izsoandras/IIT_5dof_robotarm/README.md

Foun an old 5 degree of freedom robotarm (Kalms&Mürb teach-robot) on my department. Decided to give it a new life. here is my progression.
