izsoandras/IIT_5dof_robotarm/(threads)

Thread 4 (2025-04-23):

Change reset capacitor

izsoandras, 2025-04-23:
Rst capacitor should be bigger to ensure reset on code upload via UART (probably 10uF)
