izsoandras/IIT_5dof_robotarm/PCB/IIT_5dof_arm_IO/IIT_5dof_arm_IO.kicad_sch.pdf

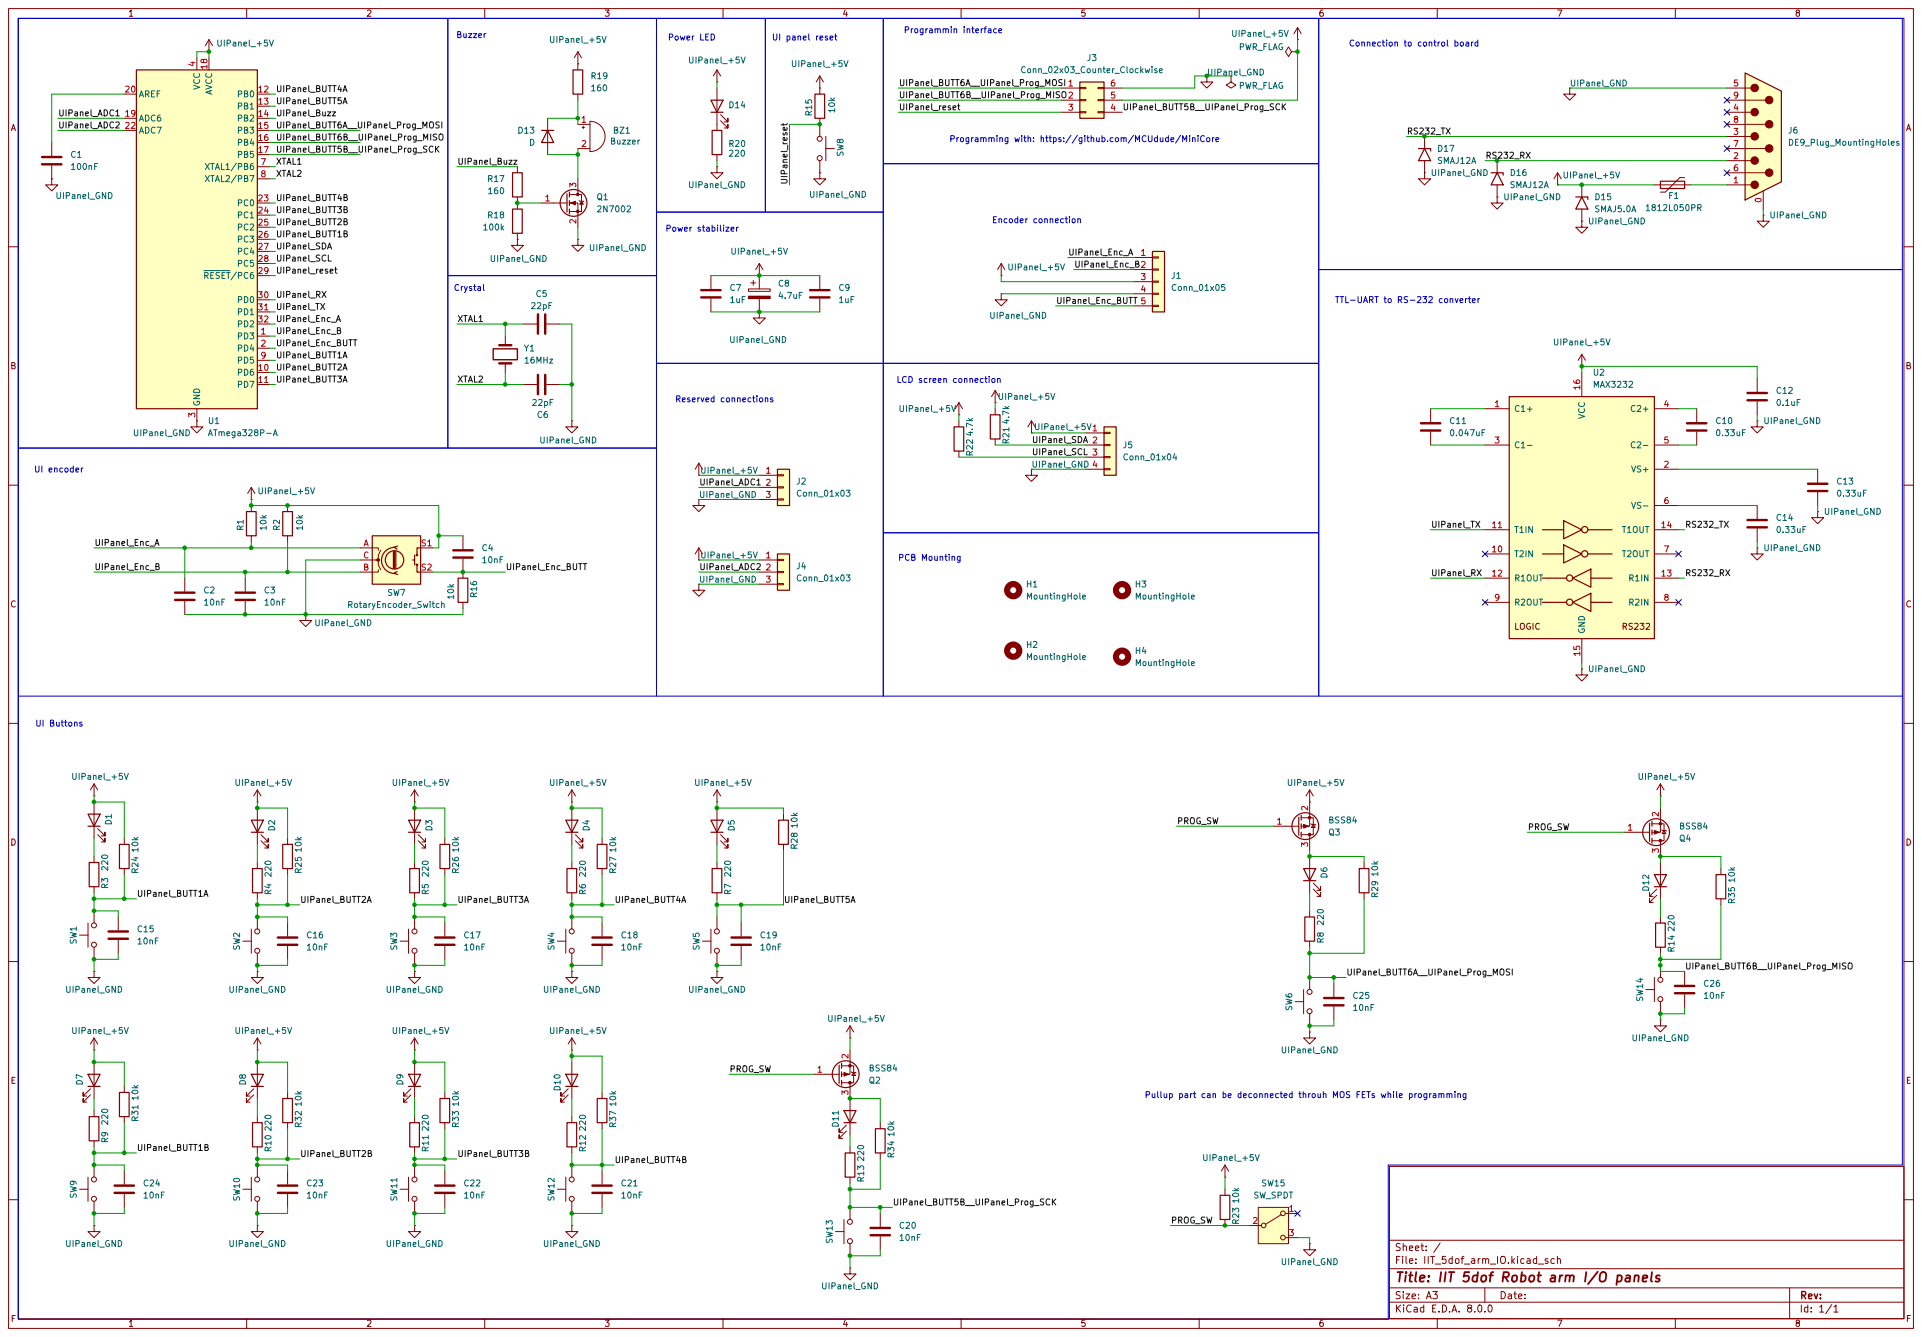
[picture p1: page 1]
