izsoandras/IIT_5dof_robotarm/PCB/IIT_5dof_arm/IIT_5dof_arm_sch.pdf

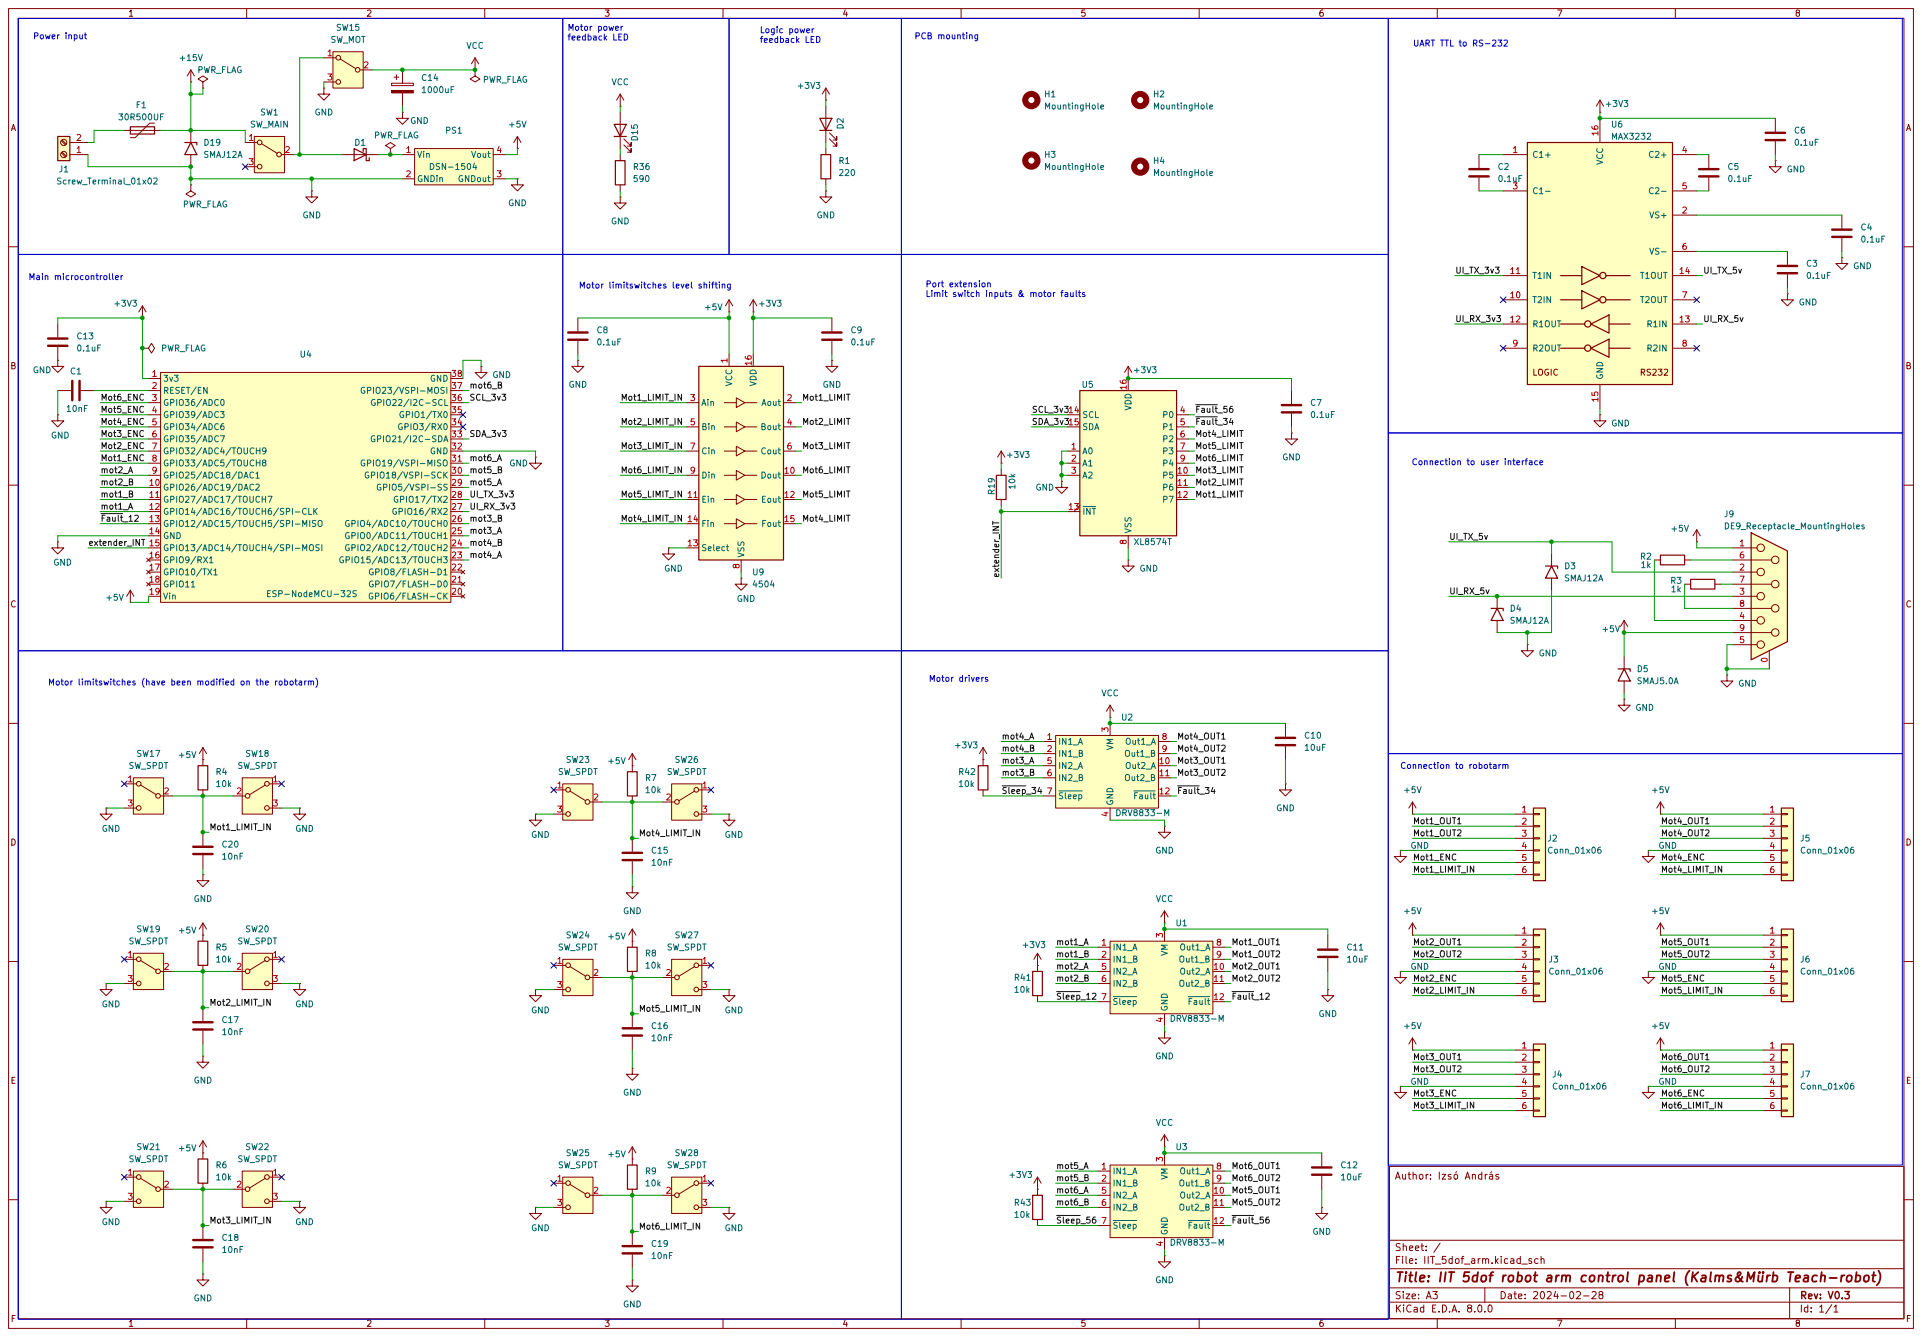
[picture p2: page 1]
