izsoandras/IIT_5dof_robotarm/PCB/IIT_5dof_arm/IIT_5dof_arm_pcb.pdf

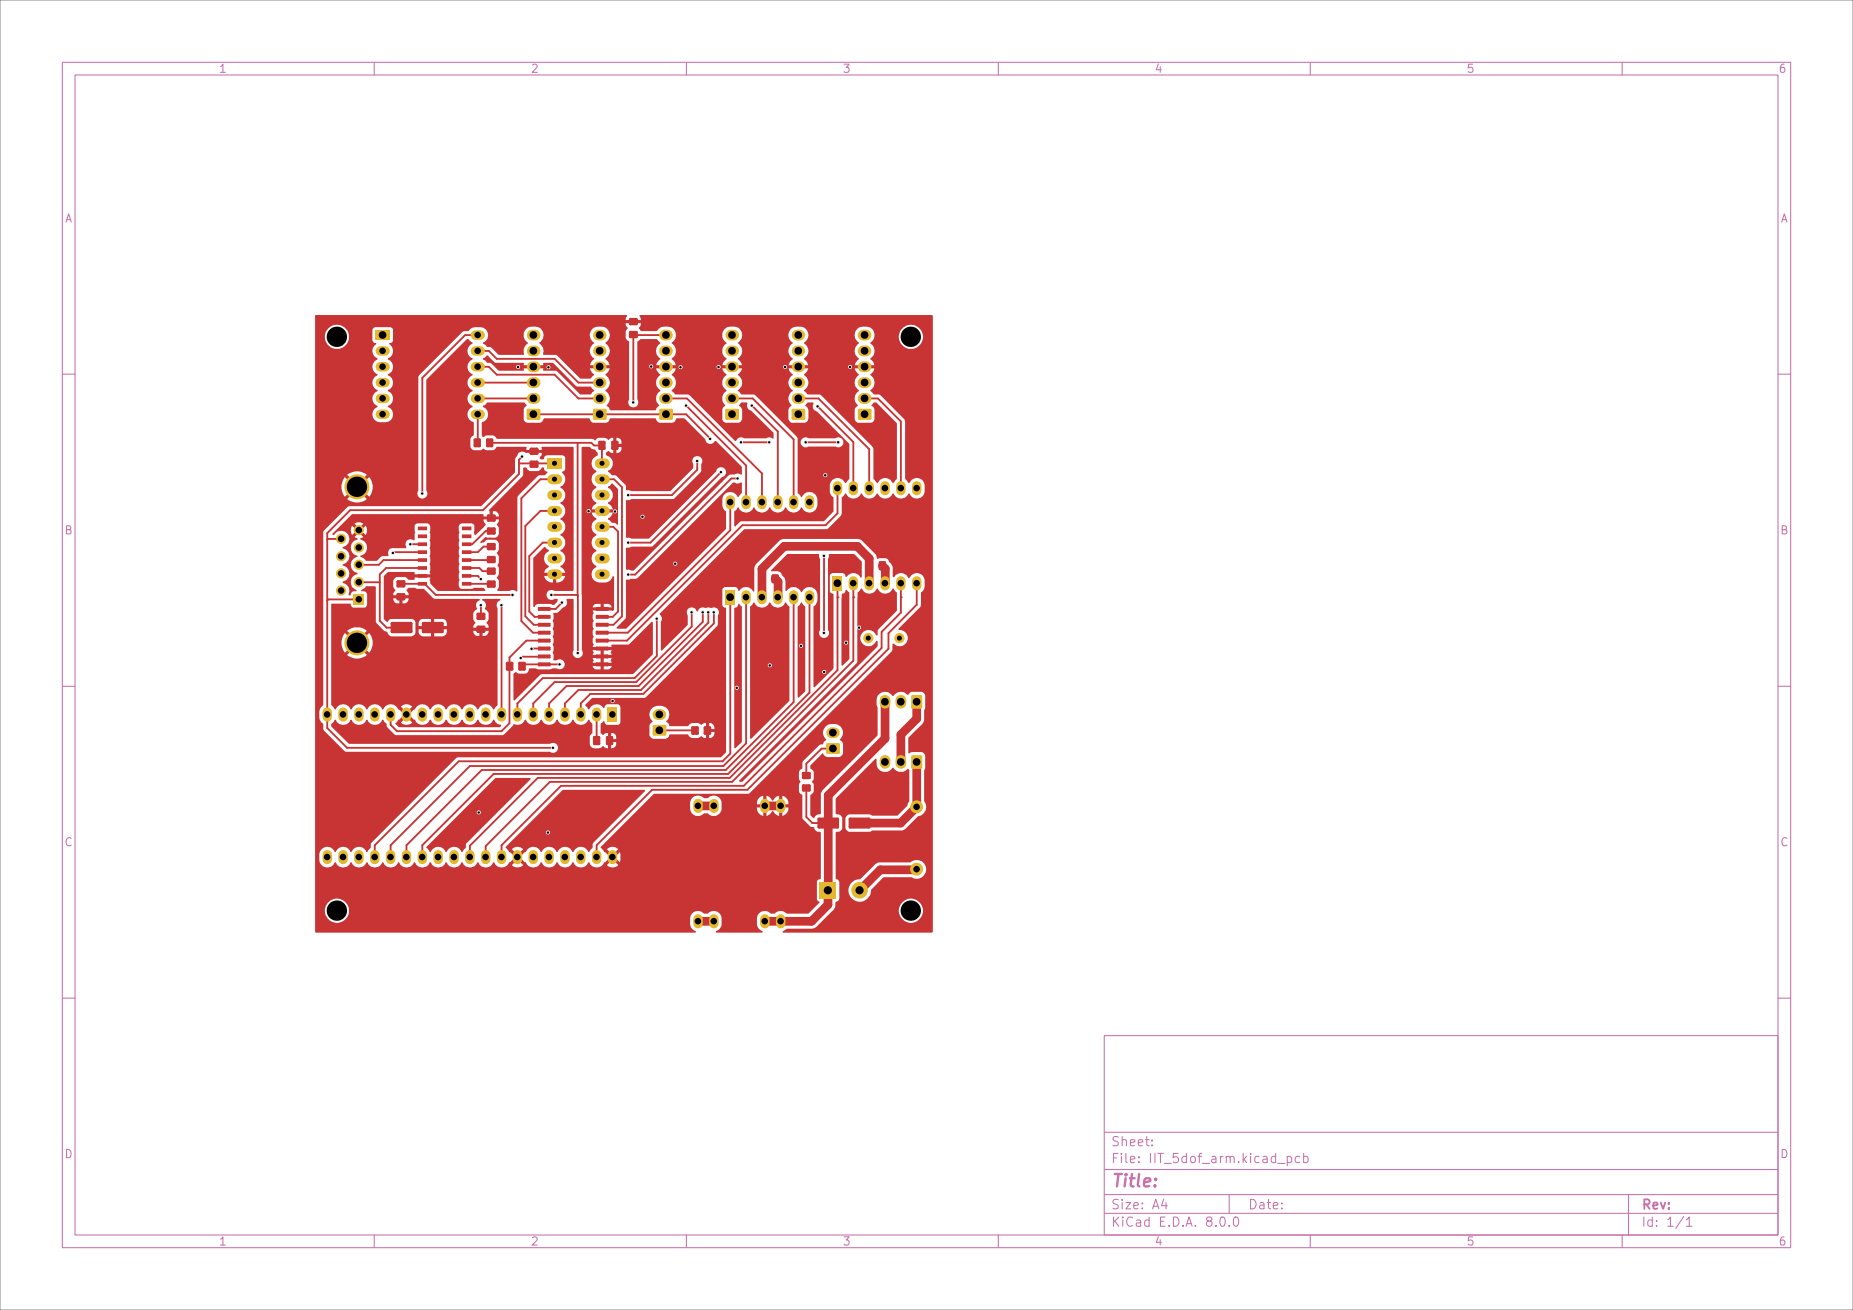
[picture p3: page 1]

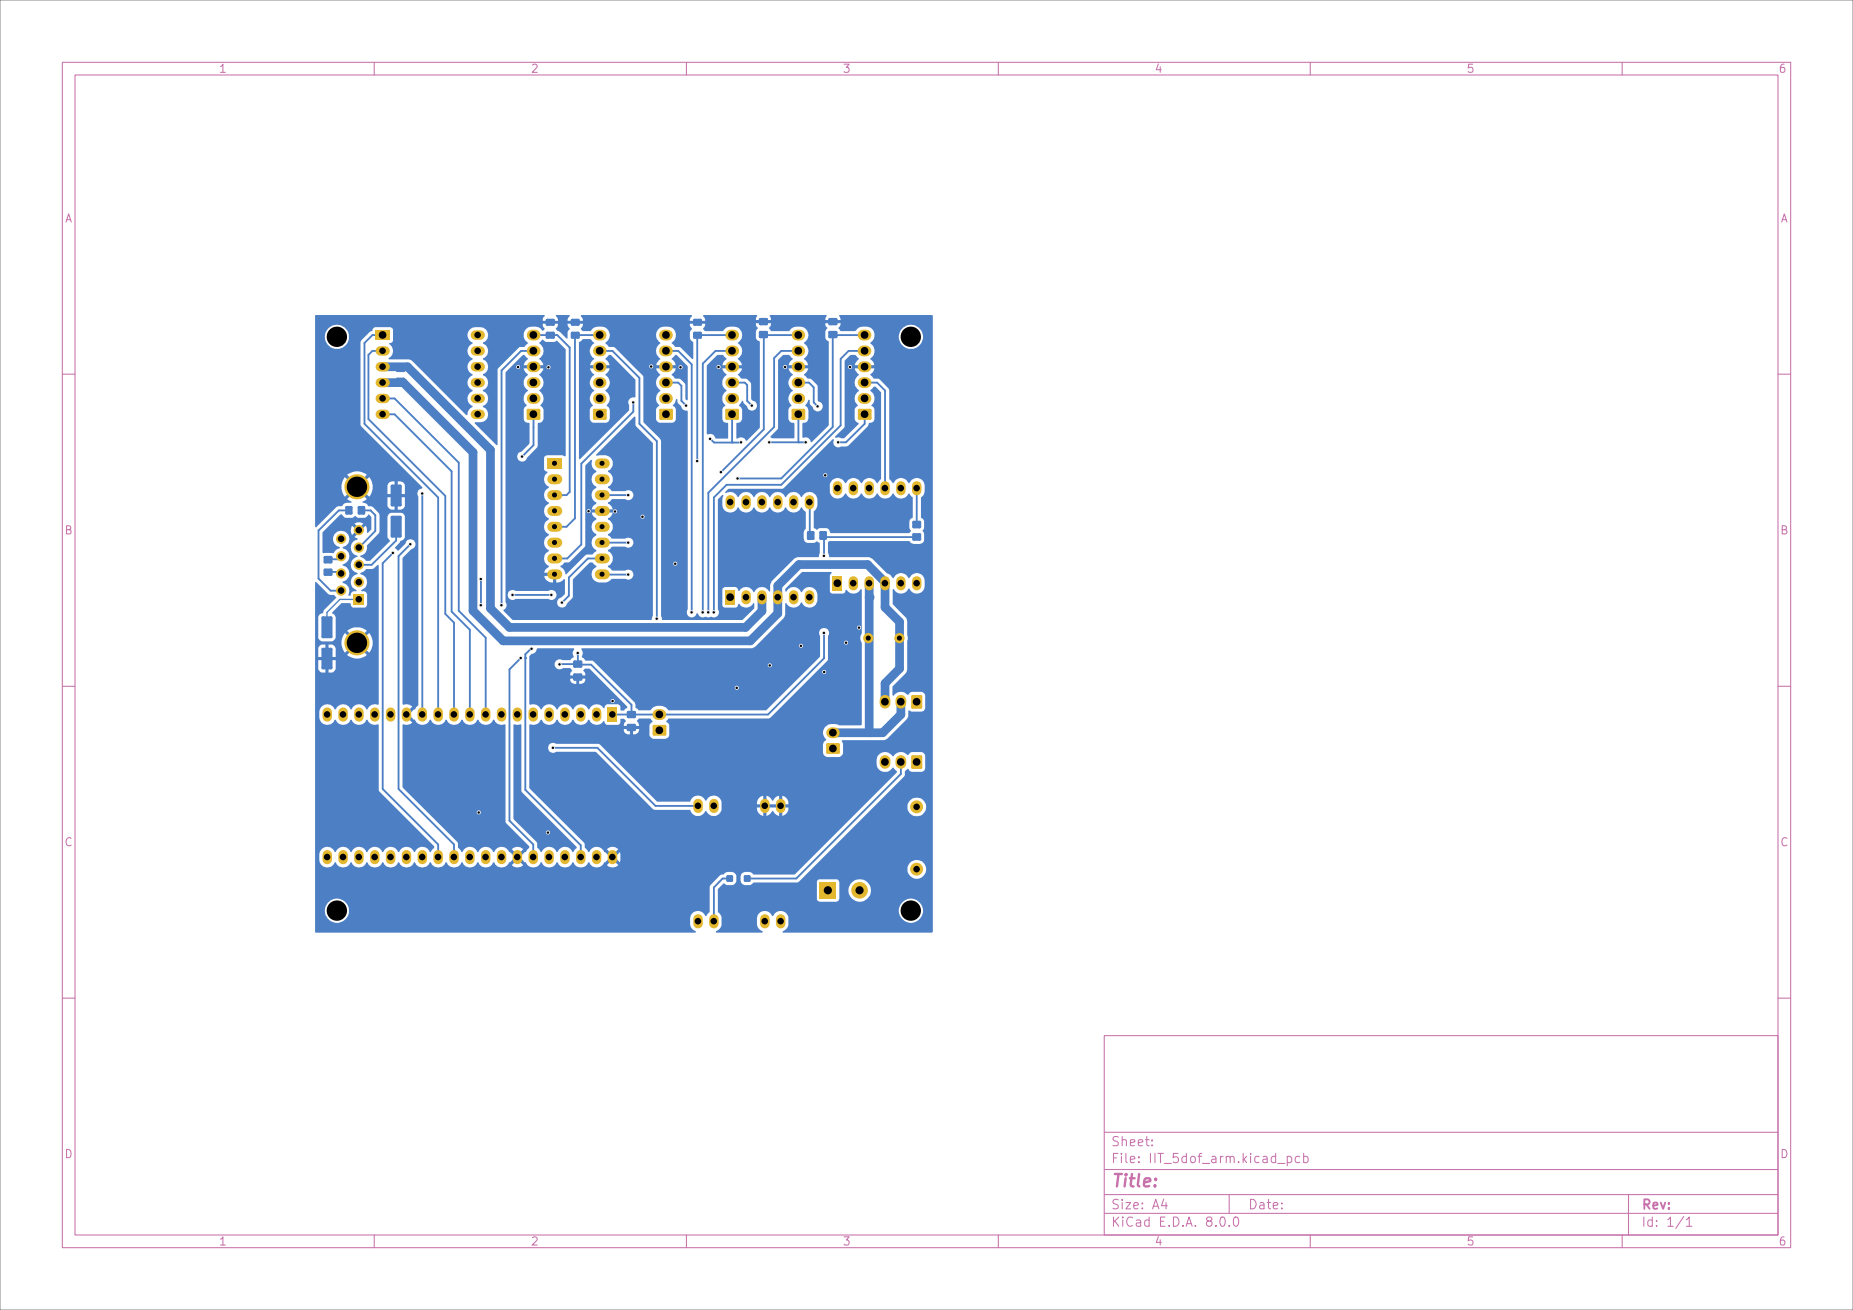
[picture p4: page 2]
