izsoandras/IIT_5dof_robotarm/PCB/IIT_5dof_arm_IO/IIT_5dof_arm_IO.kicad_pcb.pdf

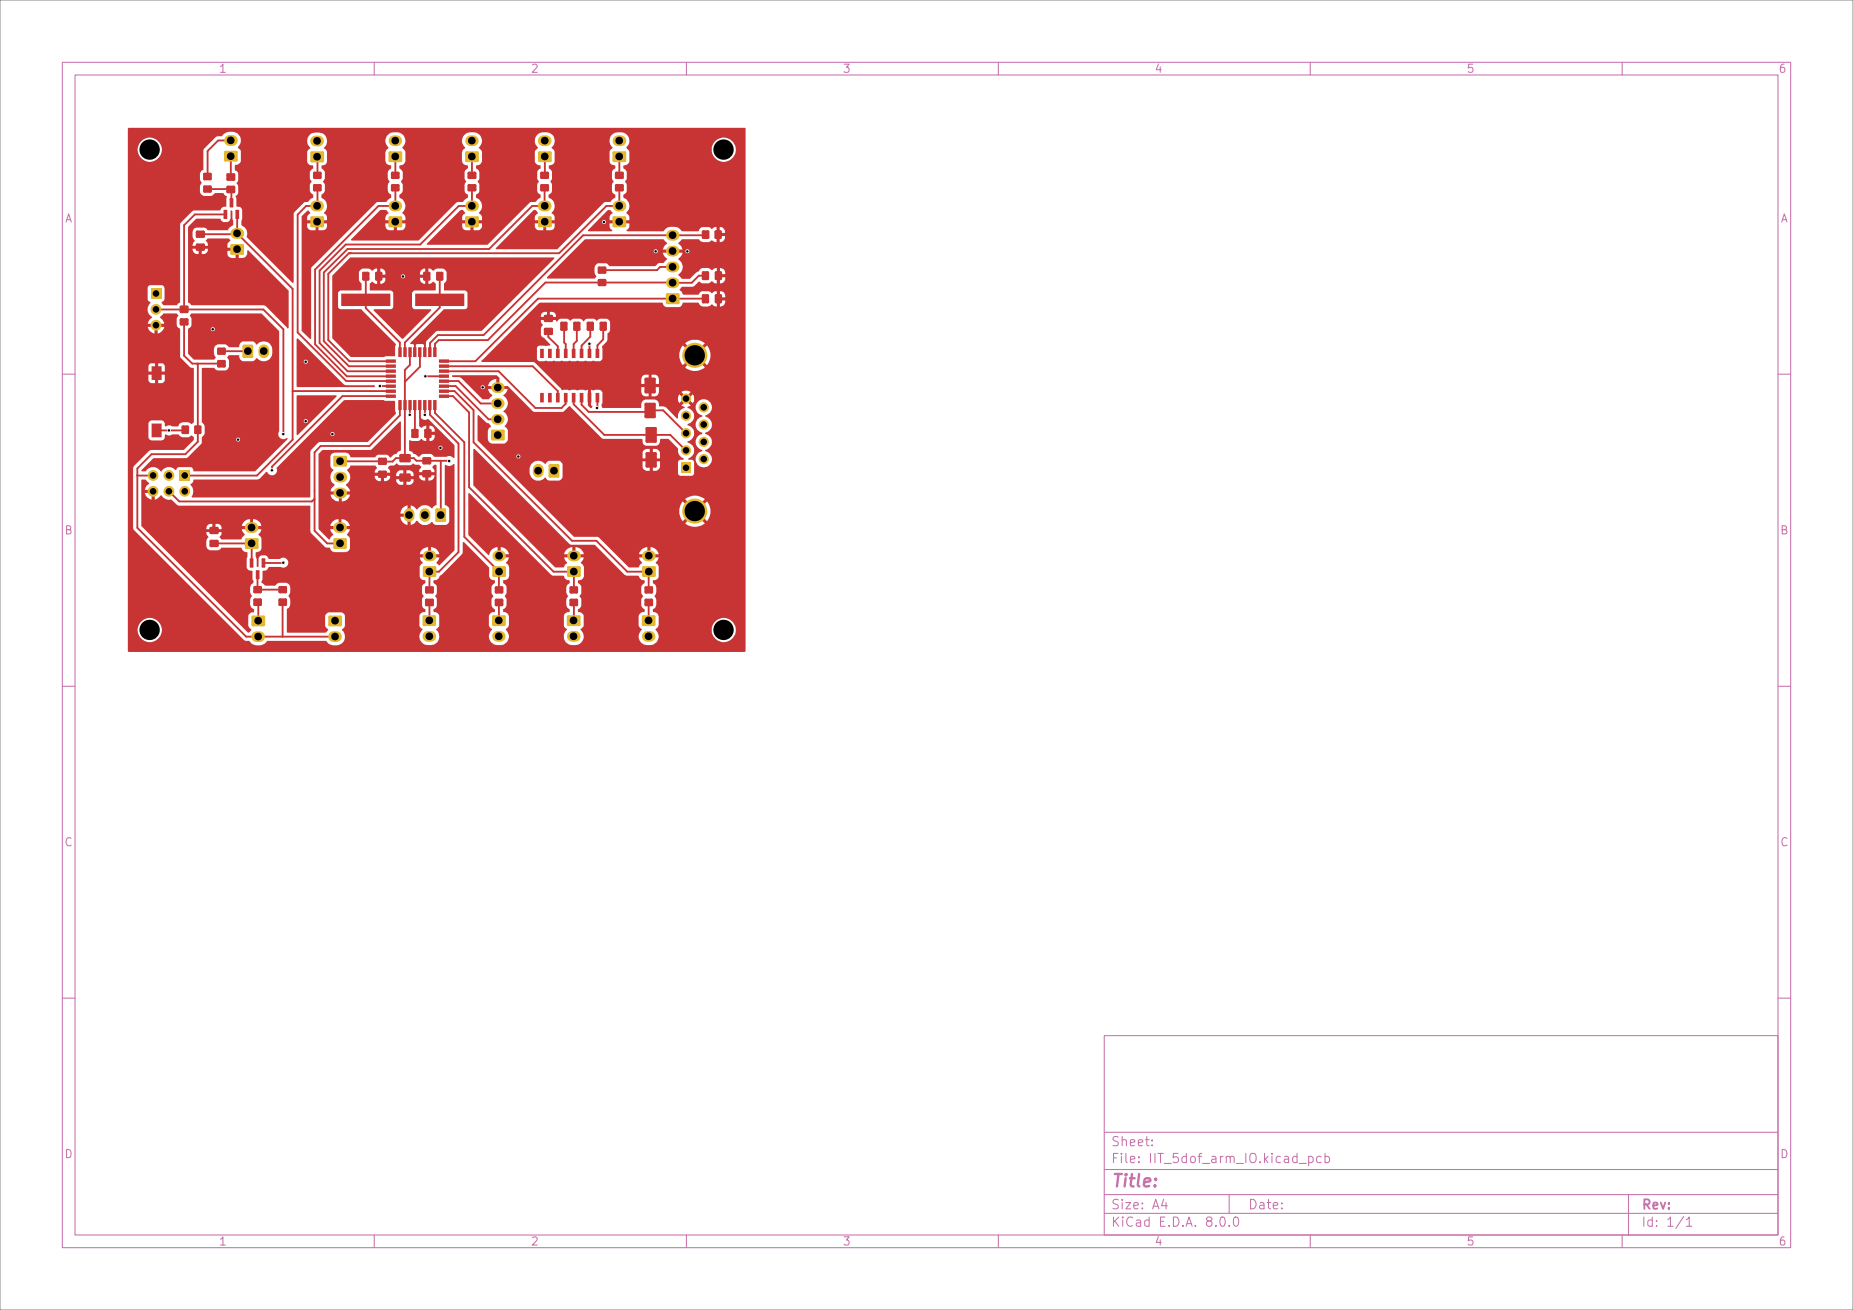
[picture p5: page 1]

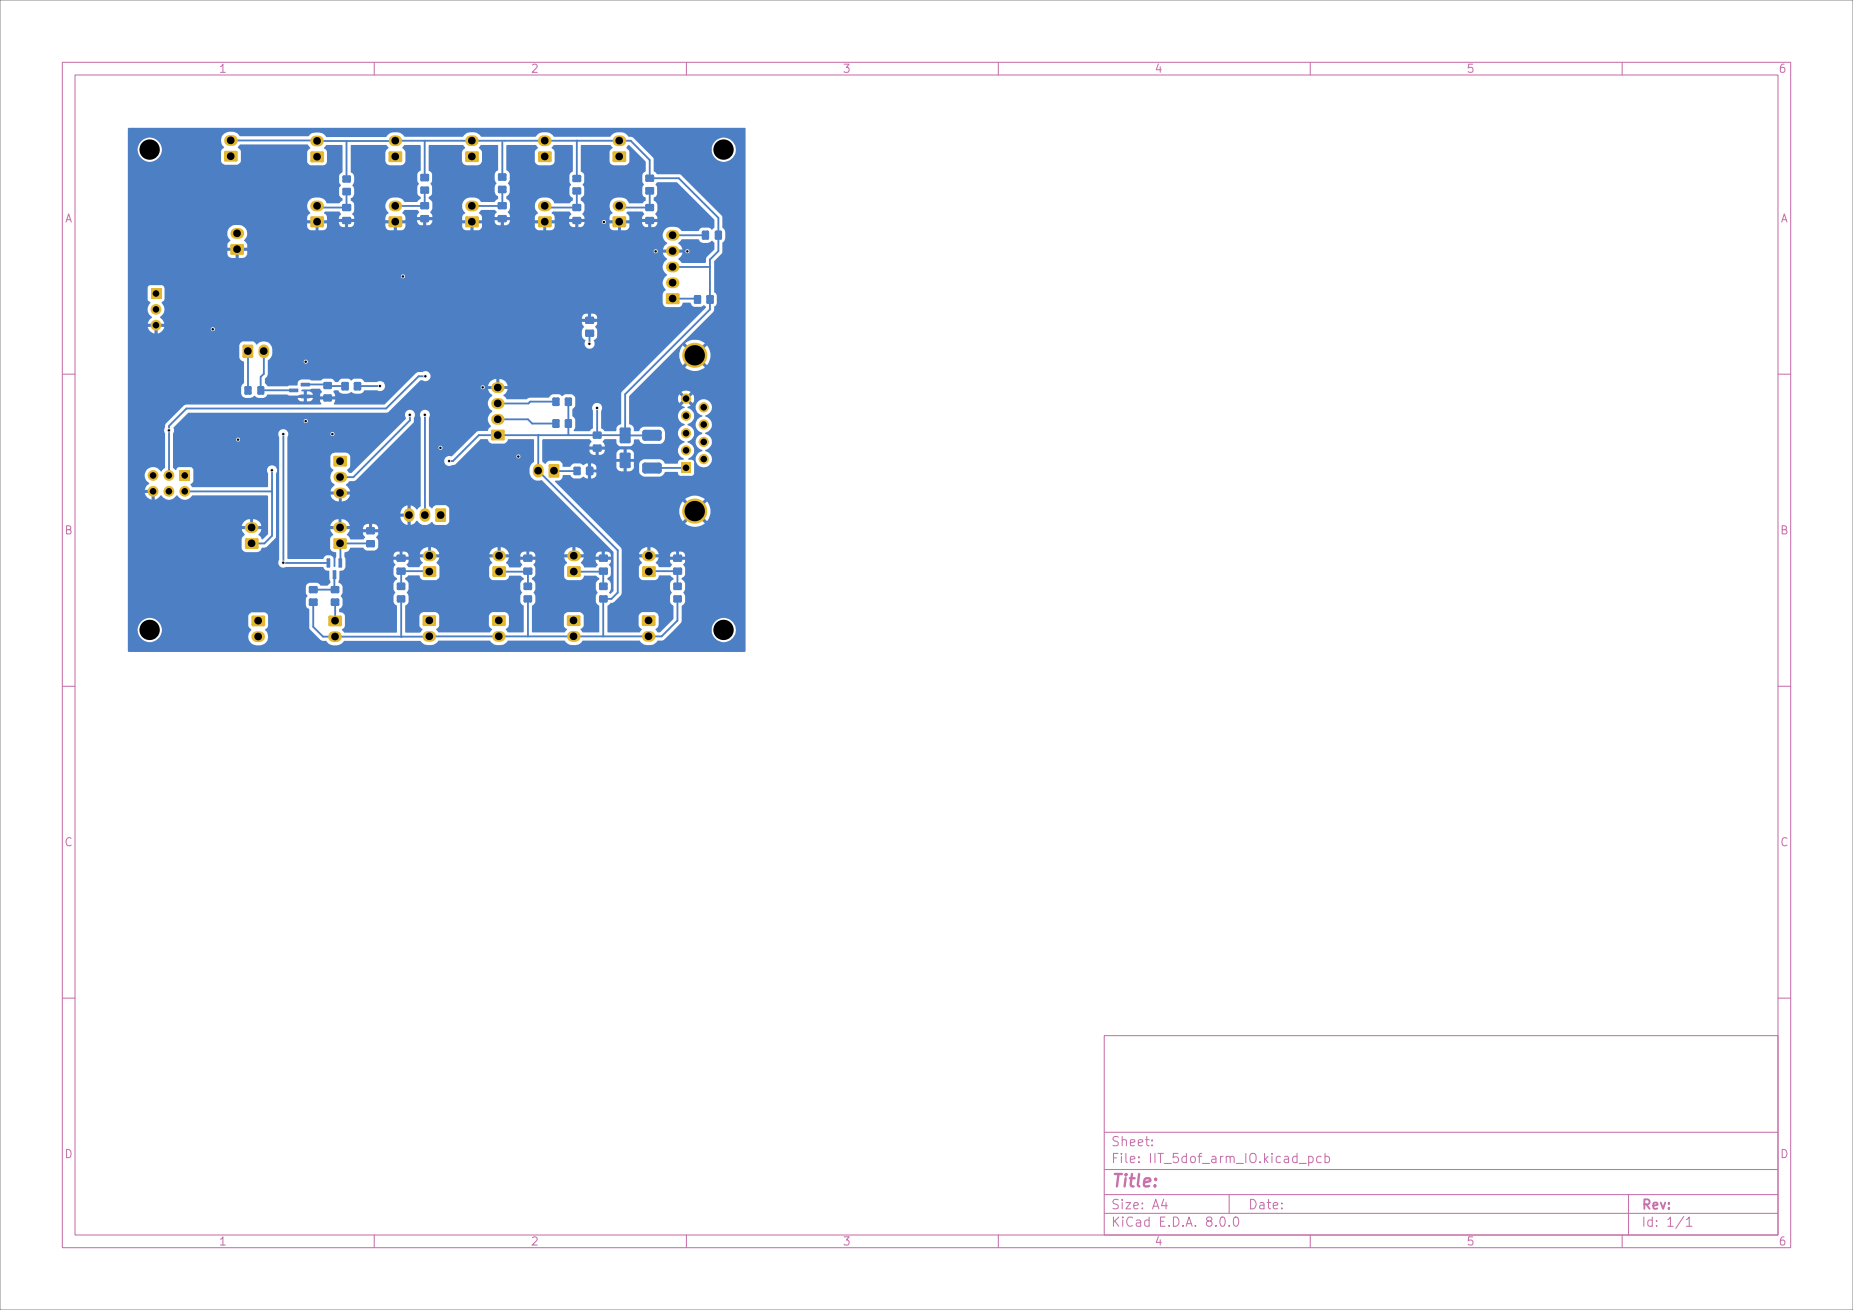
[picture p6: page 2]
