izsoandras/IIT_5dof_robotarm/PCB/IIT_5dof_arm/IIT_5dof_arm.kicad_pcb

## KiCad design PCB/IIT_5dof_arm/IIT_5dof_arm.kicad_pcb (2024-10-30)

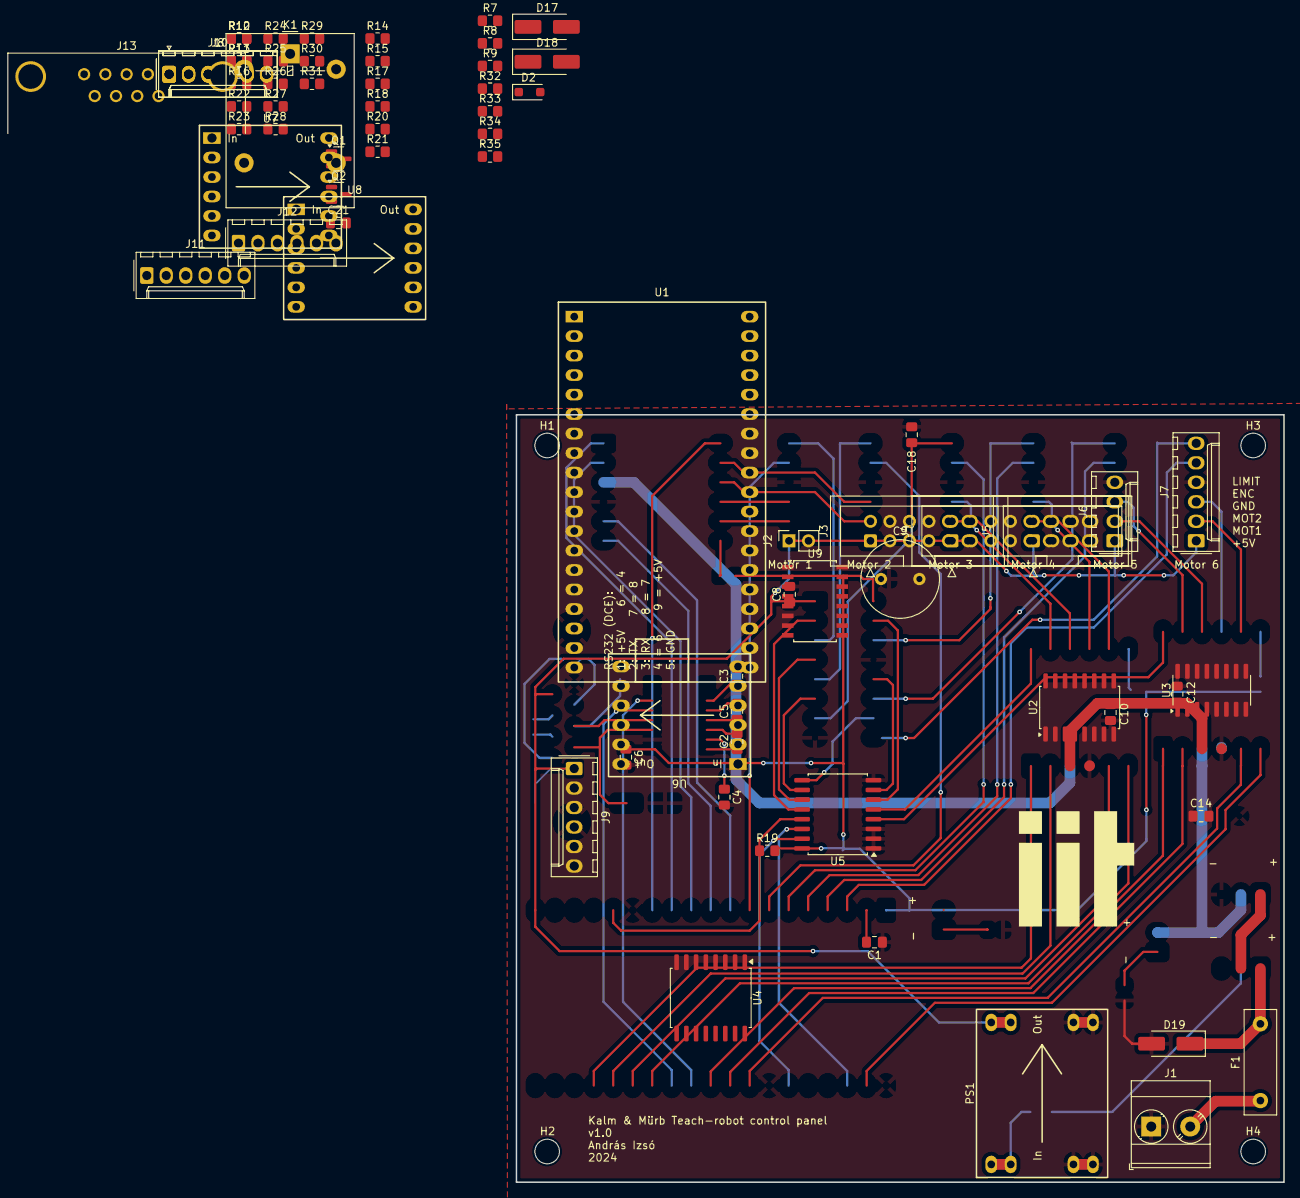
[picture p7: board IIT_5dof_arm.kicad_pcb from above]

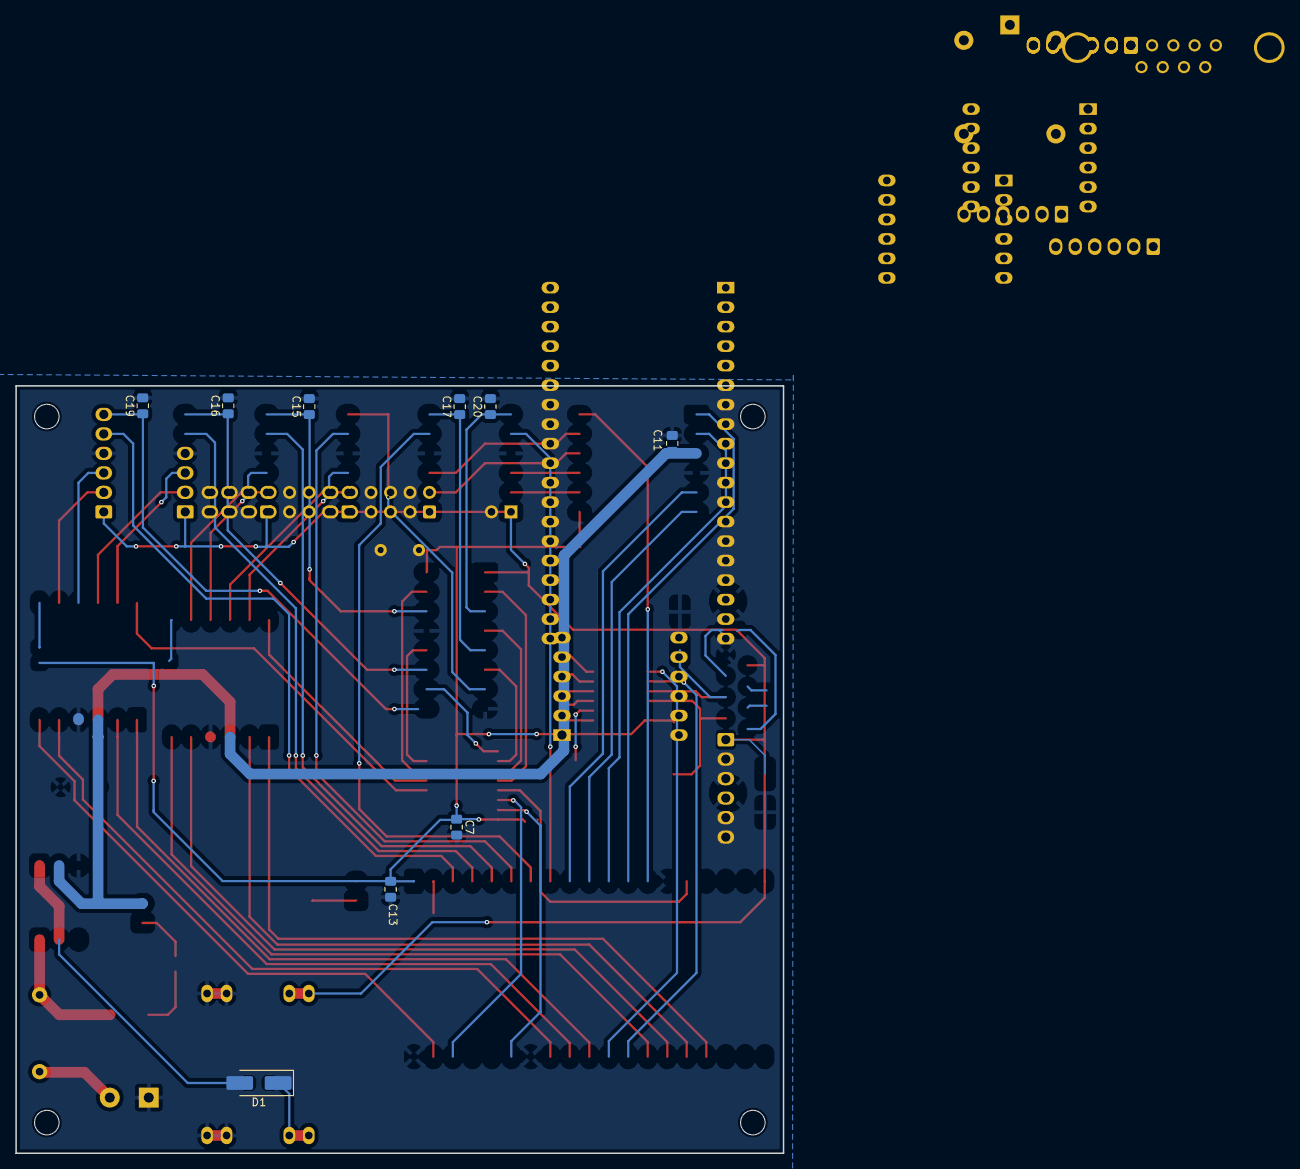
[picture p8: board IIT_5dof_arm.kicad_pcb from below]

Board: 2 copper layers, 100.0 x 100.0 mm, 86 parts (9 on the bottom side), 105 nets.

Parts:
C1, C10, C11, C13, C14, C17, C18, C19, C20, C21: 0.1uF; C_0805_2012Metric_Pad1.18x1.45mm_HandSolder
C2, C3, C4, C5, C6, C7, C8: 10nF; C_0805_2012Metric_Pad1.18x1.45mm_HandSolder
C9: 1000uF; C_Radial_D10.0mm_H16.0mm_P5.00mm
C12, C15, C16: 10uF; C_0805_2012Metric_Pad1.18x1.45mm_HandSolder
D1, D17, D18: SMAJ12A; D_SMA_Handsoldering
D2: D_Schottky; D_SOD-123F
D19: SMAJ5.0A; D_SMA_Handsoldering
F1: 30R500UF; C_Rect_L13.5mm_W4.0mm_P10.00mm_FKS3_FKP3_MKS4
H1, H2, H3, H4: MountingHole; MountingHole_3.2mm_M3
J1: Screw_Terminal_01x02; TerminalBlock_Phoenix_MKDS-3-2-5.08_1x02_P5.08mm_Horizontal
J2: Conn_01x02; PinSocket_1x02_P2.54mm_Vertical
J3: Conn_02x06_Odd_Even; IDC-Header_2x06_P2.54mm_Vertical
J4: Conn_02x08_Odd_Even; IDC-Header_2x08_P2.54mm_Vertical
J5: Conn_02x04_Odd_Even; IDC-Header_2x04_P2.54mm_Vertical
J6: Conn_01x04; Molex_KK-254_AE-6410-04A_1x04_P2.54mm_Vertical
J7, J8, J9, J10, J11, J12: Conn_01x06; Molex_KK-254_AE-6410-06A_1x06_P2.54mm_Vertical
J13: DE9_Receptacle_MountingHoles; DSUB-9_Female_Horizontal_P2.77x2.84mm_EdgePinOffset4.94mm_H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
K1: G5LE-1; Relay_SPDT_Omron-G5LE-1
PS1: DSN-1504
Q1, Q2: 2N7002; SOT-23
R7: 220; R_0805_2012Metric_Pad1.20x1.40mm_HandSolder
R8: 100k; R_0805_2012Metric_Pad1.20x1.40mm_HandSolder
R9, R13, R14, R16, R24, R25, R26, R27, R29, R31, R33: 10k; R_0805_2012Metric_Pad1.20x1.40mm_HandSolder
R10, R11, R12, R15, R17, R32, R34: 1k; R_0805_2012Metric_Pad1.20x1.40mm_HandSolder
R18, R19, R20, R21, R22, R23: 3k; R_0805_2012Metric_Pad1.20x1.40mm_HandSolder
R28, R30: 4k7; R_0805_2012Metric_Pad1.20x1.40mm_HandSolder
R35: 2k; R_0805_2012Metric_Pad1.20x1.40mm_HandSolder
U1: NodeMCU32S
U2: 74LS157; SO-16_5.3x10.2mm_P1.27mm
U3: 4504; SOIC-16_3.9x9.9mm_P1.27mm
U4, U5: XL8574T; SOIC-16W_7.5x10.3mm_P1.27mm
U6, U7, U8: DRV8833-M
U9: MAX3232; SOIC-16W_5.3x10.2mm_P1.27mm

Connections:
+3V3: C1.2, C11.1, C13.1, C14.1, C19.1, J3.1, J3.3, J3.5, J3.7, J3.9, J3.11, J4.5, J4.9, J4.13, J4.15, R24.2, R25.1, R26.1, R27.1, R28.2, R29.1, R30.2, R31.1, U1.1 (3v3), U2.16 (VCC), U3.16 (VDD), U4.16 (VDD), U5.16 (VDD), U9.16 (VCC)
+5V: C10.1, D19.1 (A1), J6.1, J7.1, J8.1, J9.1, J10.1, J11.1, J12.1, J13.1, J13.9, K1.5, PS1.4 (Vout), R33.1, U1.19 (Vin), U3.1 (VCC)
+15V: D1.1 (A1), F1.2, J5.1
/EMG_LED-: J4.10, R10.1
/EMG_signal: J5.5, Q1.1 (G), R10.2, R34.2, R35.1, U1.3 (GPIO36/ADC0)
/EMG_signal_5V: J13.7, R33.2, R34.1
/ESP-CAM/RX: J6.2, U2.6 (I1b)
/ESP-CAM/TX: J6.3, U2.9 (Zc)
/EspRST: C2.2, J2.1, U1.2 (RESET/EN)
/LED_3v3-: J4.6, R15.1
/LED_MotPower-: J4.8, R16.1
/LED_PowerOn-: J4.2, R13.1
/LED_VCC-: J4.4, R14.1
/Limit1_LED-: J3.2, R23.1
/Limit2_LED-: J3.4, R22.1
/Limit3_LED-: J3.6, R21.1
/Limit4_LED-: J3.8, R20.1
/Limit5_LED-: J3.10, R19.1
/Limit6_LED-: J3.12, R18.1
/Man/Aut SW: J5.7, R31.2, U4.5 (P1)
/Mot1_ENC: J7.5, U2.5 (I0b), U2.13 (I1d)
/Mot1_ENC/ESP-CAM_RX: U1.9 (GPIO25/ADC18/DAC1), U2.7 (Zb)
/Mot1_LIMIT: U3.2 (Aout), U5.12 (P7)
/Mot1_LIMIT_IN: C3.1, J7.6, U3.3 (Ain)
/Mot1_OUT1: J7.2, U7.8 (Out1_A)
/Mot1_OUT2: J7.3, U7.9 (Out1_B)
/Mot2_ENC: J8.5, U1.8 (GPIO33/ADC5/TOUCH8)
/Mot2_LIMIT: U3.4 (Bout), U5.11 (P6)
/Mot2_LIMIT_IN: C4.1, J8.6, U3.5 (Bin)
/Mot2_OUT1: J8.2, U7.10 (Out2_A)
/Mot2_OUT2: J8.3, U7.11 (Out2_B)
/Mot3_ENC: J9.5, U1.7 (GPIO32/ADC4/TOUCH9)
/Mot3_LIMIT: U3.6 (Cout), U5.10 (P5)
/Mot3_LIMIT_IN: C5.1, J9.6, U3.7 (Cin)
/Mot3_OUT1: J9.2, U6.10 (Out2_A)
/Mot3_OUT2: J9.3, U6.11 (Out2_B)
/Mot4_ENC: J10.5, U1.6 (GPIO35/ADC7)
/Mot4_LIMIT: U3.15 (Fout), U5.6 (P2)
/Mot4_LIMIT_IN: C6.1, J10.6, U3.14 (Fin)
/Mot4_OUT1: J10.2, U6.8 (Out1_A)
/Mot4_OUT2: J10.3, U6.9 (Out1_B)
/Mot5_ENC: J11.5, U1.5 (GPIO34/ADC6)
/Mot5_LIMIT: U3.12 (Eout), U5.7 (P3)
/Mot5_LIMIT_IN: C7.1, J11.6, U3.11 (Ein)
/Mot5_OUT1: J11.2, U8.10 (Out2_A)
/Mot5_OUT2: J11.3, U8.11 (Out2_B)
/Mot6_ENC: J12.5, U1.4 (GPIO39/ADC3)
/Mot6_LIMIT: U3.10 (Dout), U5.9 (P4)
/Mot6_LIMIT_IN: C8.1, J12.6, U3.9 (Din)
/Mot6_OUT1: J12.2, U8.8 (Out1_A)
/Mot6_OUT2: J12.3, U8.9 (Out1_B)
/MotEnable: R7.1, U4.6 (P2)
/MotPower: C12.1, C15.1, C16.1, J4.7, K1.1, U6.3 (VM), U7.3 (VM), U8.3 (VM)
/PowerOn: D2.2 (A), J4.1, J5.2, J5.3
/SCL_3v3: R28.1, U1.36 (GPIO22/I2C-SCL), U4.14 (SCL), U5.14 (SCL)
/SDA_3v3: R30.1, U1.33 (GPIO21/I2C-SDA), U4.15 (SDA), U5.15 (SDA)
/TBD_Led1: R11.2, U4.11 (P6)
/TBD_Led1-: J4.14, R11.1
/TBD_Led2: R12.2, U4.12 (P7)
/TBD_Led2-: J4.16, R12.1
/UI_RX_3v3: U1.27 (GPIO16/RX2), U9.12 (R1OUT)
/UI_RX_5v: D17.1 (A1), J13.3, U9.13 (R1IN)
/UI_TX_3v3: U1.28 (GPIO17/TX2), U9.11 (T1IN)
/UI_TX_5v: D18.1 (A1), J13.2, U9.14 (T1OUT)
/alt_mot1A: U2.3 (I1a), U4.9 (P4)
/alt_mot1_enc: U2.12 (Zd), U4.10 (P5)
/extender_INT: R24.1, U1.15 (GPIO13/ADC14/TOUCH4/SPI-MOSI), U4.13 (~INT), U5.13 (~INT)
/mot1_A: U2.4 (Za), U7.1 (IN1_A)
/mot1_A/ESP-CAM_TX: U1.13 (GPIO12/ADC15/TOUCH5/SPI-MISO), U2.2 (I0a), U2.10 (I1c)
/mot1_B: U1.12 (GPIO14/ADC16/TOUCH6/SPI-CLK), U7.2 (IN1_B)
/mot2_A: U1.10 (GPIO26/ADC19/DAC2), U7.5 (IN2_A)
/mot2_B: U1.11 (GPIO27/ADC17/TOUCH7), U7.6 (IN2_B)
/mot3_A: U1.25 (GPIO0/ADC11/TOUCH1), U6.5 (IN2_A)
/mot3_B: U1.26 (GPIO4/ADC10/TOUCH0), U6.6 (IN2_B)
/mot4_A: U1.23 (GPIO15/ADC13/TOUCH3), U6.1 (IN1_A)
/mot4_B: U1.24 (GPIO2/ADC12/TOUCH2), U6.2 (IN1_B)
/mot5_A: U1.29 (GPIO5/VSPI-SS), U8.1 (IN1_A)
/mot5_B: U1.30 (GPIO18/VSPI-SCK), U8.2 (IN1_B)
/mot6_A: U1.31 (GPIO19/VSPI-MISO), U8.5 (IN2_A)
/mot6_B: U1.37 (GPIO23/VSPI-MOSI), U8.6 (IN2_B)
/useESP-CAM: R17.1, U2.1 (S), U4.7 (P3)
/useESP-CAM_LED+: J4.11, R17.2
/~Fault_12: U4.4 (P0), U7.12 (~Fault)
/~Fault_34: U5.5 (P1), U6.12 (~Fault)
/~Fault_56: U5.4 (P0), U8.12 (~Fault)
/~Sleep_12: R26.2, U7.7 (~Sleep)
/~Sleep_34: R25.2, U6.7 (~Sleep)
/~Sleep_56: R27.2, U8.7 (~Sleep)
GND: C1.1, C2.1, C3.2, C4.2, C5.2, C6.2, C7.2, C8.2, C9.2, C10.2, C11.2, C12.2, C13.2, C14.2, C15.2, C16.2, C19.2, C20.2, C21.2, D1.2 (A2), D17.2 (A2), D18.2 (A2), D19.2 (A2), J1.1, J2.2, J4.12, J5.6, J5.8, J6.4, J7.4, J8.4, J9.4, J10.4, J11.4, J12.4, J13.0 (PAD), J13.5, PS1.2 (GNDin), PS1.3 (GNDout), Q2.2 (S), R8.2, R9.2, R13.2, R14.2, R15.2, R16.2, R18.2, R19.2, R20.2, R21.2, R22.2, R23.2, R35.2, U1.14 (GND), U1.32 (GND), U1.38 (GND), U2.8 (GND), U3.8 (VSS), U3.13 (Select), U4.2 (A1), U4.3 (A2), U4.8 (VSS), U5.1 (A0), U5.2 (A1), U5.3 (A2), U5.8 (VSS), U6.4 (GND), U7.4 (GND), U8.4 (GND), U9.15 (GND)
unnamed: D2.1 (K), PS1.1 (Vin)
unnamed: F1.1, J1.2
unnamed: J13.4, R32.1
unnamed: J13.6, R32.2
unnamed: K1.2, Q1.3 (D)
unnamed: Q1.2 (S), Q2.3 (D)
unnamed: Q2.1 (G), R7.2, R8.1
unnamed: R9.1, U2.11 (I0c), U2.14 (I0d), U2.15 (E)
unnamed: R29.2, U4.1 (A0)
unnamed: C17.1, U9.1 (C1+)
unnamed: C17.2, U9.3 (C1-)
unnamed: C18.1, U9.4 (C2+)
unnamed: C18.2, U9.5 (C2-)
unnamed: C21.1, U9.2 (VS+)
unnamed: C20.1, U9.6 (VS-)
VCC: C9.1, J4.3, J5.4, K1.3
