izsoandras/IIT_5dof_robotarm/PCB/IIT_5dof_arm_IO/IIT_5dof_arm_IO.kicad_pcb

## KiCad design PCB/IIT_5dof_arm_IO/IIT_5dof_arm_IO.kicad_pcb (2024-09-21)

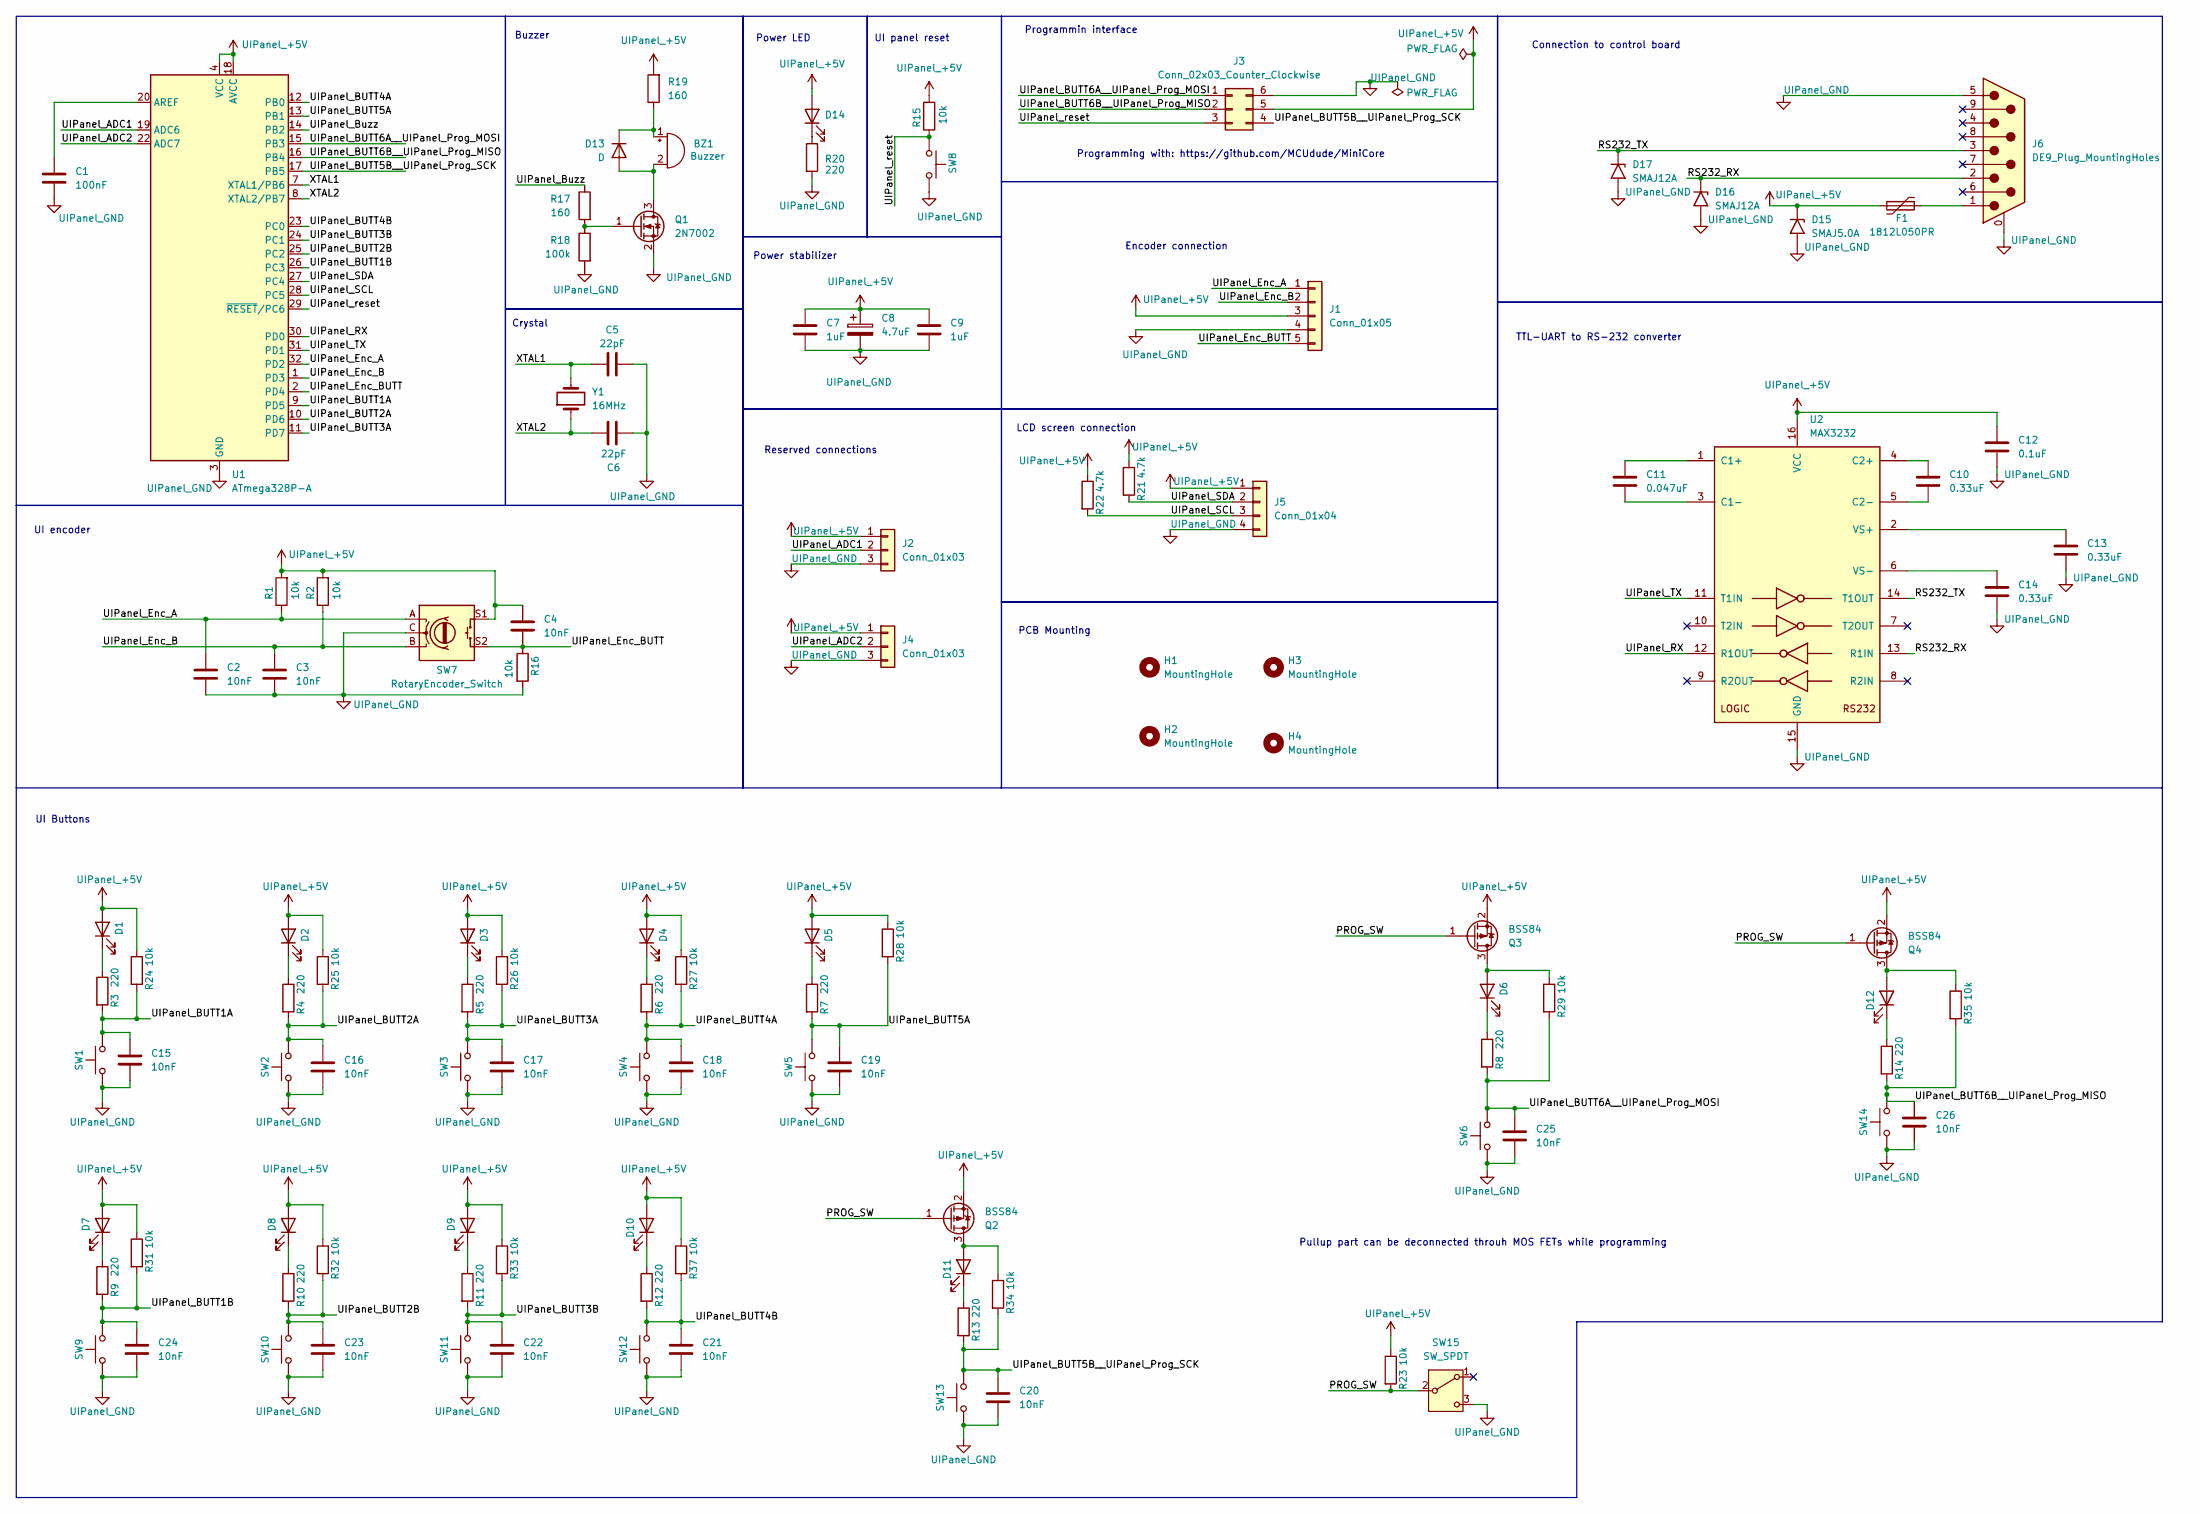
[picture p9: schematic IIT_5dof_arm_IO.kicad_sch, IIT 5dof Robot arm I/O panels]

Parts:
BZ1: Buzzer; Molex_KK-254_AE-6410-02A_1x02_P2.54mm_Vertical
C1: 100nF; C_0805_2012Metric_Pad1.18x1.45mm_HandSolder
C2, C3, C4, C15, C16, C17, C18, C19, C20, C21, C22, C23, C24, C25, C26: 10nF; C_0805_2012Metric_Pad1.18x1.45mm_HandSolder
C5, C6: 22pF; C_0805_2012Metric_Pad1.18x1.45mm_HandSolder
C7, C9: 1uF; C_0805_2012Metric_Pad1.18x1.45mm_HandSolder
C8: 4.7uF; C_1206_3216Metric_Pad1.33x1.80mm_HandSolder
C10, C13, C14: 0.33uF; C_0805_2012Metric_Pad1.18x1.45mm_HandSolder
C11: 0.047uF; C_0805_2012Metric_Pad1.18x1.45mm_HandSolder
C12: 0.1uF; C_0805_2012Metric_Pad1.18x1.45mm_HandSolder
D1, D2, D3, D4, D5, D6, D7, D8, D9, D10, D11, D12, D14: LED; Molex_KK-254_AE-6410-02A_1x02_P2.54mm_Vertical
D13: D; D_0805_2012Metric_Pad1.15x1.40mm_HandSolder
D15: SMAJ5.0A; D_SMA
D16, D17: SMAJ12A; D_SMA
F1: 1812L050PR; 1812L050PR__1.78mm_3.15mm_3.45mm
H1, H2, H3, H4: MountingHole; MountingHole_3.2mm_M3
J1: Conn_01x05; Molex_KK-254_AE-6410-05A_1x05_P2.54mm_Vertical
J2, J4: Conn_01x03; Molex_KK-254_AE-6410-03A_1x03_P2.54mm_Vertical
J3: Conn_02x03_Counter_Clockwise; PinHeader_2x03_P2.54mm_Vertical
J5: Conn_01x04; Molex_KK-254_AE-6410-04A_1x04_P2.54mm_Vertical
J6: DE9_Plug_MountingHoles; DSUB-9_Male_Horizontal_P2.77x2.84mm_EdgePinOffset7.70mm_Hou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
Q1: 2N7002; SOT-23
Q2, Q3, Q4: BSS84; SOT-23
R1, R2, R15, R16, R23, R24, R25, R26, R27, R28, R29, R31, R32, R33, R34, R35, R37: 10k; R_0805_2012Metric_Pad1.20x1.40mm_HandSolder
R3, R4, R5, R6, R7, R8, R9, R10, R11, R12, R13, R14, R20: 220; R_0805_2012Metric_Pad1.20x1.40mm_HandSolder
R17, R19: 160; R_0805_2012Metric_Pad1.20x1.40mm_HandSolder
R18: 100k; R_0805_2012Metric_Pad1.20x1.40mm_HandSolder
R21, R22: 4.7k; R_0805_2012Metric_Pad1.20x1.40mm_HandSolder
SW1, SW2, SW3, SW4, SW5, SW6, SW9, SW10, SW11, SW12, SW13, SW14: SW_Push; Molex_KK-254_AE-6410-02A_1x02_P2.54mm_Vertical
SW7: RotaryEncoder_Switch; Molex_for_encoder_1x05_P2.54mm_Vertical
SW8: SW_Push; SW_SPST_FSMSM
SW15: SW_SPDT; PinHeader_1x03_P2.54mm_Vertical
U1: ATmega328P-A; TQFP-32_7x7mm_P0.8mm
U2: MAX3232; SOIC-16W_5.3x10.2mm_P1.27mm
Y1: 16MHz; Crystal_SMD_HC49-SD_HandSoldering

Connections:
/PROG_SW: Q2.1 (G), Q3.1 (G), Q4.1 (G), R23.2, SW15.2 (B)
/RS232_RX: D16.1 (A1), J6.2, U2.13 (R1IN)
/RS232_TX: D17.1 (A1), J6.3, U2.14 (T1OUT)
/UIPanel_ADC1: J2.2, U1.19 (ADC6)
/UIPanel_ADC2: J4.2, U1.22 (ADC7)
/UIPanel_BUTT1A: C15.1, R3.2, R24.2, SW1.2, U1.9 (PD5)
/UIPanel_BUTT1B: C24.1, R9.2, R31.2, SW9.1, U1.26 (PC3)
/UIPanel_BUTT2A: C16.1, R4.2, R25.2, SW2.2, U1.10 (PD6)
/UIPanel_BUTT2B: C23.1, R10.2, R32.2, SW10.1, U1.25 (PC2)
/UIPanel_BUTT3A: C17.1, R5.2, R26.2, SW3.2, U1.11 (PD7)
/UIPanel_BUTT3B: C22.1, R11.2, R33.2, SW11.1, U1.24 (PC1)
/UIPanel_BUTT4A: C18.1, R6.2, R27.2, SW4.2, U1.12 (PB0)
/UIPanel_BUTT4B: C21.1, R12.2, R37.2, SW12.1, U1.23 (PC0)
/UIPanel_BUTT5A: C19.1, R7.2, R28.2, SW5.2, U1.13 (PB1)
/UIPanel_BUTT5B__UIPanel_Prog_SCK: C20.1, J3.4, R13.2, R34.2, SW13.1, U1.17 (PB5)
/UIPanel_BUTT6A__UIPanel_Prog_MOSI: C25.1, J3.1, R8.2, R29.2, SW6.2, U1.15 (PB3)
/UIPanel_BUTT6B__UIPanel_Prog_MISO: C26.1, J3.2, R14.2, R35.2, SW14.1, U1.16 (PB4)
/UIPanel_Buzz: R17.1, U1.14 (PB2)
/UIPanel_Enc_A: C2.1, J1.1, R1.1, SW7.A, U1.32 (PD2)
/UIPanel_Enc_B: C3.1, J1.2, R2.1, SW7.B, U1.1 (PD3)
/UIPanel_Enc_BUTT: C4.2, J1.5, R16.1, SW7.S2, U1.2 (PD4)
/UIPanel_RX: U1.30 (PD0), U2.12 (R1OUT)
/UIPanel_SCL: J5.3, R22.2, U1.28 (PC5)
/UIPanel_SDA: J5.2, R21.2, U1.27 (PC4)
/UIPanel_TX: U1.31 (PD1), U2.11 (T1IN)
/UIPanel_reset: J3.3, R15.1, SW8.1, U1.29 (~RESET/PC6)
/XTAL1: C5.1, U1.7 (XTAL1/PB6), Y1.2
/XTAL2: C6.2, U1.8 (XTAL2/PB7), Y1.1
unnamed: BZ1.1 (+), D13.1 (K), R19.1
unnamed: BZ1.2 (-), D13.2 (A), Q1.3 (D)
unnamed: D1.1 (K), R3.1
unnamed: D2.1 (K), R4.1
unnamed: D3.1 (K), R5.1
unnamed: D4.1 (K), R6.1
unnamed: D5.1 (K), R7.1
unnamed: D6.2 (A), Q3.3 (D), R29.1
unnamed: D6.1 (K), R8.1
unnamed: D7.1 (K), R9.1
unnamed: D8.1 (K), R10.1
unnamed: D9.1 (K), R11.1
unnamed: D10.1 (K), R12.1
unnamed: D11.2 (A), Q2.3 (D), R34.1
unnamed: D11.1 (K), R13.1
unnamed: D12.2 (A), Q4.3 (D), R35.1
unnamed: D12.1 (K), R14.1
unnamed: D14.1 (K), R20.1
unnamed: F1.1, J6.1
unnamed: Q1.1 (G), R17.2, R18.1
unnamed: C1.1, U1.20 (AREF)
unnamed: C11.1, U2.1 (C1+)
unnamed: C11.2, U2.3 (C1-)
unnamed: C10.1, U2.4 (C2+)
unnamed: C10.2, U2.5 (C2-)
unnamed: C13.1, U2.2 (VS+)
unnamed: C14.1, U2.6 (VS-)
UIPanel_+5V: C4.1, C7.1, C8.1, C9.1, C12.1, D1.2 (A), D2.2 (A), D3.2 (A), D4.2 (A), D5.2 (A), D7.2 (A), D8.2 (A), D9.2 (A), D10.2 (A), D14.2 (A), D15.1 (A1), F1.2, J1.3, J2.1, J3.5, J4.1, J5.1, Q2.2 (S), Q3.2 (S), Q4.2 (S), R1.2, R2.2, R15.2, R19.2, R21.1, R22.1, R23.1, R24.1, R25.1, R26.1, R27.1, R28.1, R31.1, R32.1, R33.1, R37.1, SW7.S1, U1.4 (VCC), U1.6 (VCC), U1.18 (AVCC), U2.16 (VCC)
UIPanel_GND: C1.2, C2.2, C3.2, C5.2, C6.1, C7.2, C8.2, C9.2, C12.2, C13.2, C14.2, C15.2, C16.2, C17.2, C18.2, C19.2, C20.2, C21.2, C22.2, C23.2, C24.2, C25.2, C26.2, D15.2 (A2), D16.2 (A2), D17.2 (A2), J1.4, J2.3, J3.6, J4.3, J5.4, J6.0 (PAD), J6.5, Q1.2 (S), R16.2, R18.2, R20.2, SW1.1, SW2.1, SW3.1, SW4.1, SW5.1, SW6.1, SW7.C, SW8.2, SW9.2, SW10.2, SW11.2, SW12.2, SW13.2, SW14.2, SW15.3 (C), U1.3 (GND), U1.5 (GND), U1.21 (GND), U2.15 (GND)

Notes on the sheet:
Crystal
Power LED
Connection to control board
Reserved connections
Programming with: https://github.com/MCUdude/MiniCore
Programmin interface
UI encoder
UI panel reset
PCB Mounting
Buzzer
UI Buttons
Encoder connection
LCD screen connection
Power stabilizer
Pullup part can be deconnected throuh MOS FETs while programming
TTL-UART to RS-232 converter

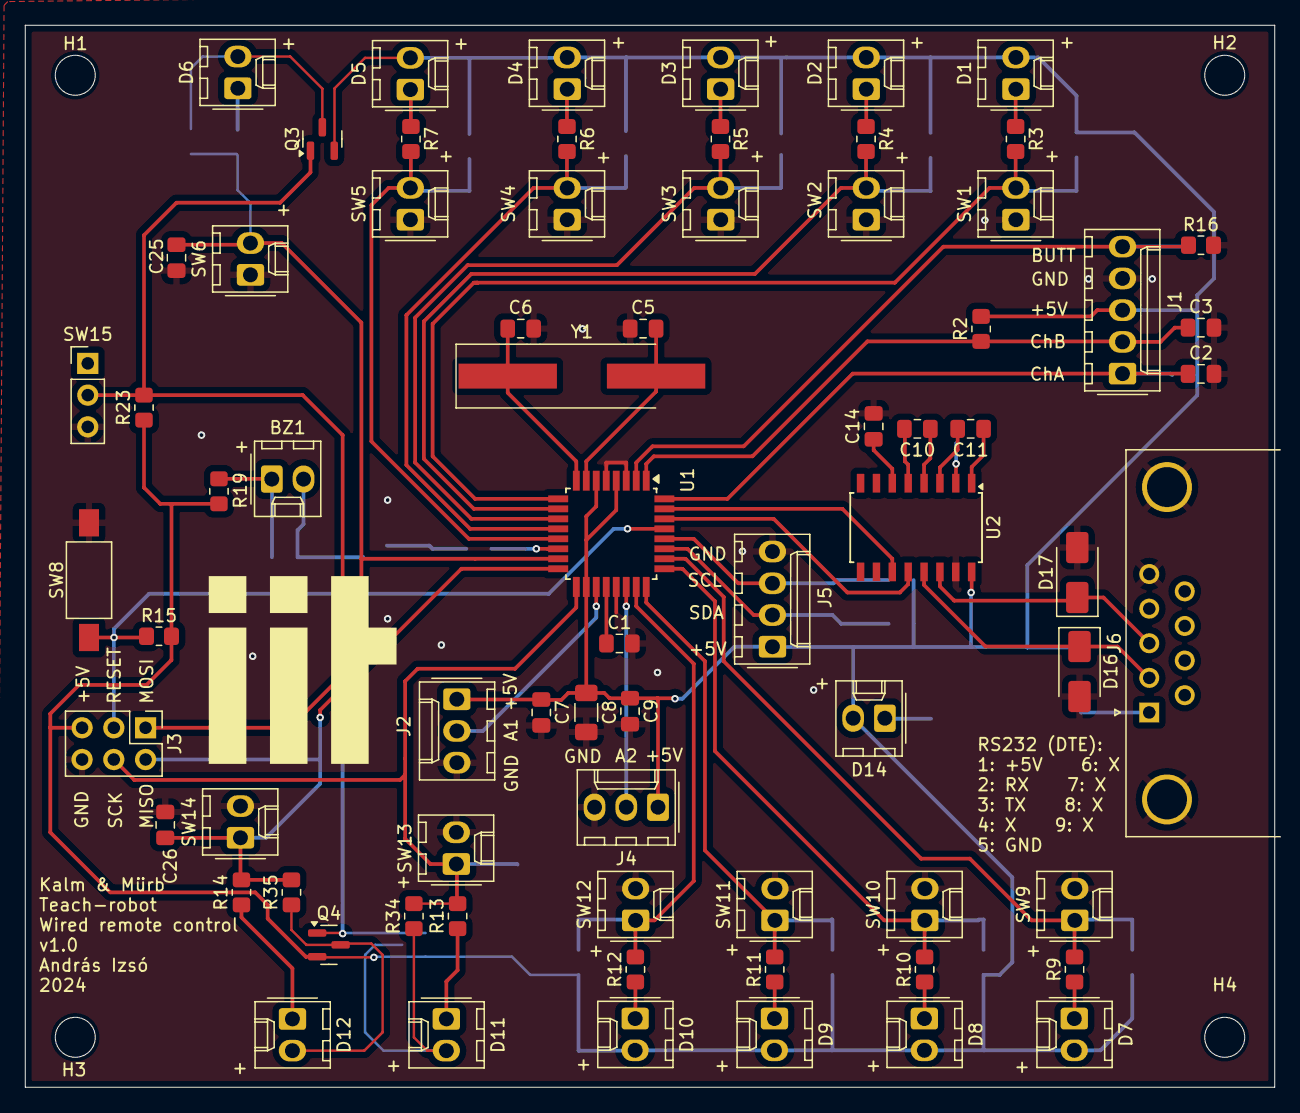
[picture p10: board IIT_5dof_arm_IO.kicad_pcb from above]

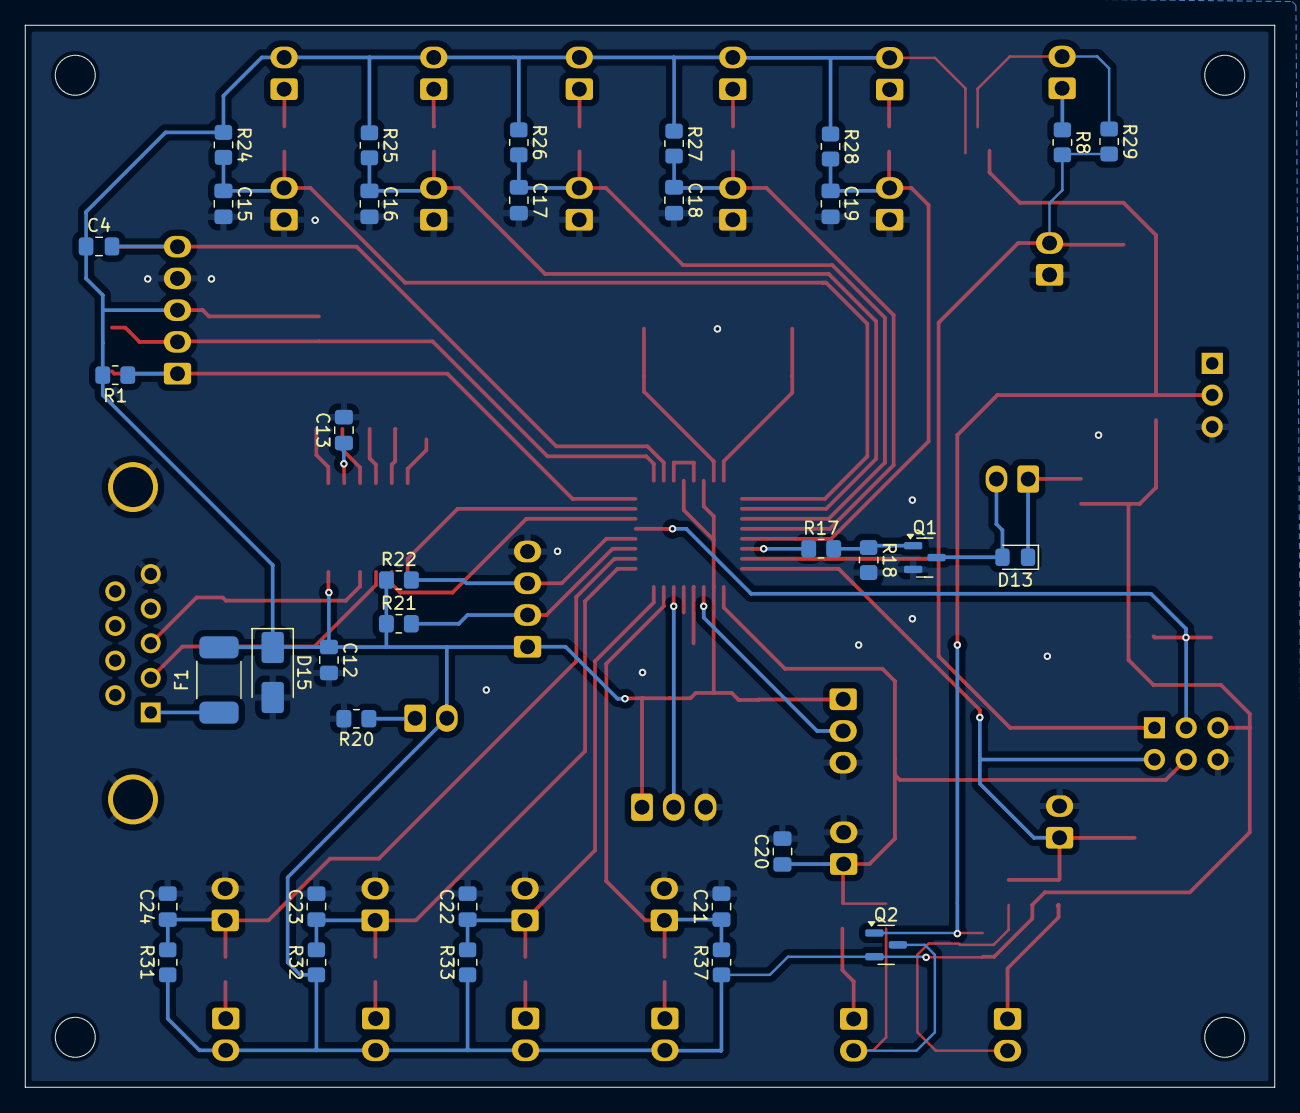
[picture p11: board IIT_5dof_arm_IO.kicad_pcb from below]

Board: 2 copper layers, 100.0 x 85.0 mm, 111 parts (35 on the bottom side), 57 nets.
