izsoandras/IIT_5dof_robotarm/(commit log)

2024-03-02 init, fixed LEDs, added I/O panels
    [IIT_5dof_arm.kicad_pcb, IIT_5dof_arm.kicad_sch]
2024-03-03 Separated UI to ATmega controller
    [IIT_5dof_arm.kicad_sch]
2024-03-03 Switch UART level shift to 2in1 fet, resistor values corrected
    [IIT_5dof_arm.kicad_sch]
2024-03-13 create separate project for IO board
    [IIT_5dof_arm.kicad_pcb, IIT_5dof_arm.kicad_sch, IIT_5dof_arm_IO.kicad_pcb, IIT_5dof_arm_IO.kicad_sch]
2024-03-18 Fixed level shifting, power input protection, buzzer drive and UI buttons
    [IIT_5dof_arm.kicad_sch]
2024-03-19 Added limit switches to schematic
    [IIT_5dof_arm.kicad_sch]
2024-03-23 Split control board and I/O cards into separate projects
    [IIT_5dof_arm.kicad_sch, IIT_5dof_arm_IO.kicad_pcb, IIT_5dof_arm_IO.kicad_sch]
2024-03-23 Control board layout
    [IIT_5dof_arm.kicad_pcb]
2024-03-23 Change motor power LED footprint to connector
    [IIT_5dof_arm.kicad_pcb, IIT_5dof_arm.kicad_sch]
2024-03-23 Organize schematic and generate initi PCB
    [IIT_5dof_arm_IO.kicad_pcb, IIT_5dof_arm_IO.kicad_sch]
2024-03-25 implement RS232
    [IIT_5dof_arm.kicad_pcb, IIT_5dof_arm.kicad_sch]
2024-03-26 Extend ESD protection on RS-232 interface and tidy up schematic
    [IIT_5dof_arm.kicad_pcb, IIT_5dof_arm.kicad_sch]
2024-03-26 Update schematic pdf
2024-03-26 Add RS-232 interface
    [IIT_5dof_arm_IO.kicad_sch]
2024-03-27 Improve LED button pullups + add detach MOSFETs
    [IIT_5dof_arm_IO.kicad_sch]
2024-03-27 Add pdf print of schematic for easier examination
2024-03-27 Add fuse, footprint assignment, minor tidy up
    [IIT_5dof_arm_IO.kicad_sch]
2024-03-27 Enhance explanation of control panel RS-232 connections
    [IIT_5dof_arm.kicad_pcb]
2024-04-08 Revise footprints
    [IIT_5dof_arm.kicad_sch]
2024-04-08 Add decoupling capacitors
    [IIT_5dof_arm.kicad_sch]
2024-04-08 Correct typo in RS232 silkscreen
    [IIT_5dof_arm.kicad_pcb]
2024-04-08 PCB layout
    [IIT_5dof_arm_IO.kicad_pcb, IIT_5dof_arm_IO.kicad_sch]
2024-04-08 Decoupling capacitors layout
    [IIT_5dof_arm.kicad_pcb, IIT_5dof_arm.kicad_sch]
2024-04-08 Add layout prints
2024-04-08 Update schematic print
2024-09-21 Fix SMAJ value, program pullup switch
    [IIT_5dof_arm_IO.kicad_pcb, IIT_5dof_arm_IO.kicad_sch]
2024-09-21 Eliminate GNDPWR
    [IIT_5dof_arm.kicad_pcb, IIT_5dof_arm.kicad_sch]
2024-09-21 Fix schematic pdf export
2024-10-03 Remove unnecessary vias
    [IIT_5dof_arm.kicad_pcb]
2024-10-30 Update schematic with new functionalities
    [IIT_5dof_arm.kicad_pcb, IIT_5dof_arm.kicad_sch]
2024-11-02 Add potmeter, mot toggle to IO
    [IIT_5dof_arm_IO.kicad_sch]
2024-11-02 Organize schematic
    [IIT_5dof_arm_IO.kicad_sch]
